climatex/Sentinel/recoverymode_gpio1.jpg

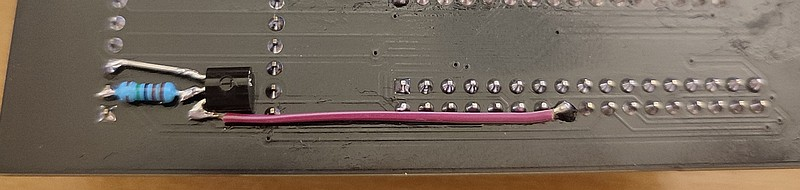
recoverymode_gpio1.jpg
