climatex/Sentinel/README.md

<p align="center">
  Project Sentinel circuit board
</p>

# Project Sentinel, an RPi Pico 2 MFM/RLL disk controller
Check out my [website article](https://boginjr.com/it/hw/sentinel) to learn more!
