climatex/Sentinel/Board/Main/Schematic/Main.png

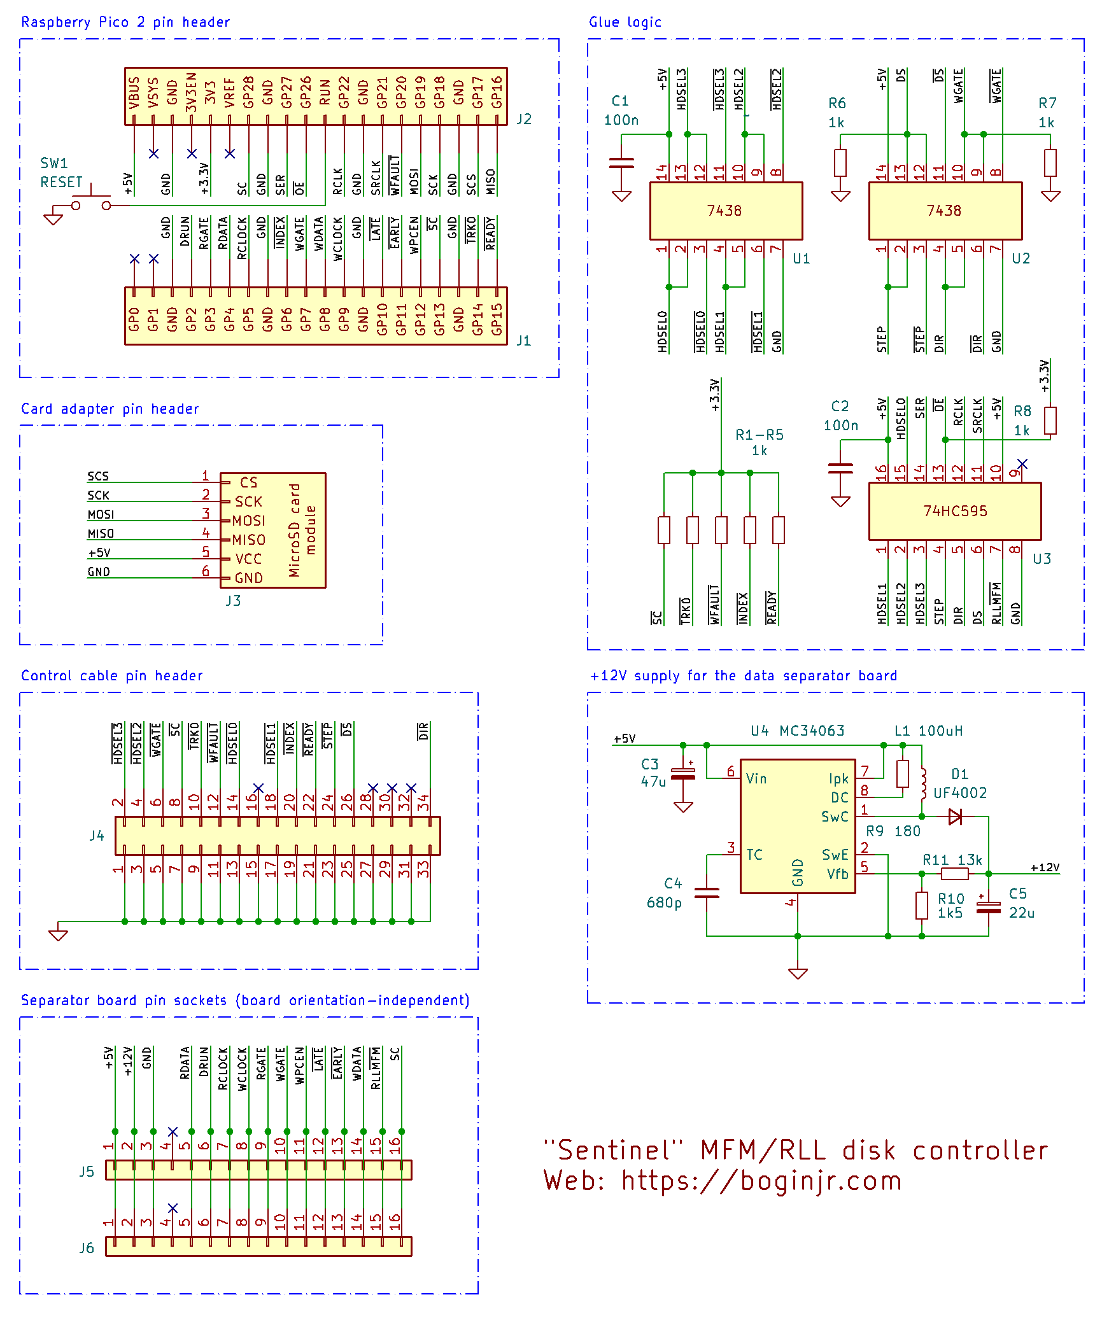
Board/Main/Schematic/Main.png
