climatex/Sentinel/Board/Main/Main.kicad_pcb

## KiCad design Board/Main/Main.kicad_pcb (2026-08-16)

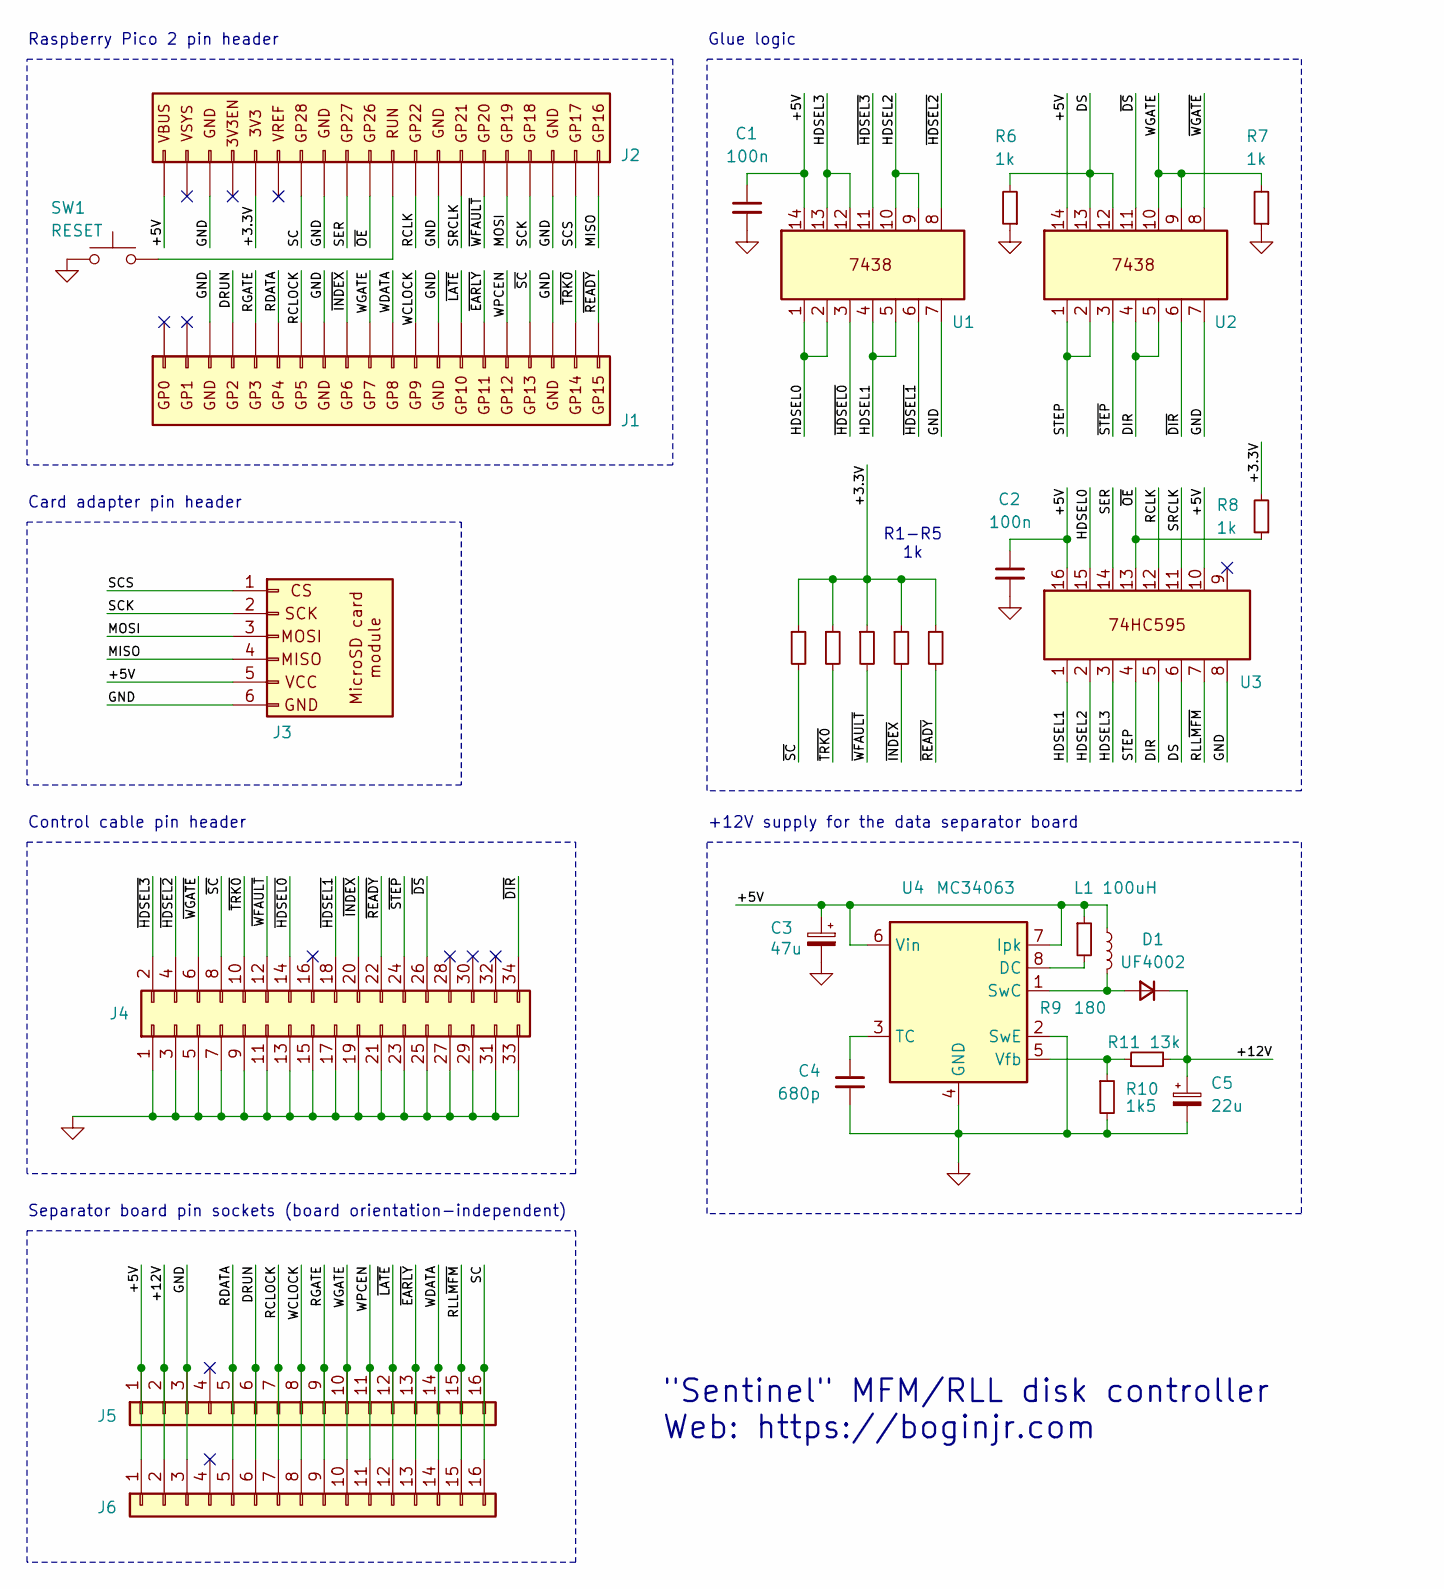
[picture p3: schematic Main.kicad_sch]

Parts:
C1, C2: 100n; C_Disc_D7.5mm_W2.5mm_P5.00mm
C3: 47u; CP_Radial_D6.3mm_P2.50mm
C4: 680p; C_Disc_D7.5mm_W2.5mm_P5.00mm
C5: 22u; CP_Radial_D6.3mm_P2.50mm
D1: UF4002; D_DO-41_SOD81_P10.16mm_Horizontal
J1, J2: Conn_01x20; PinSocket_1x20_P2.54mm_Vertical
J3: Digital; PinHeader_1x06_P2.54mm_Vertical
J4: PinHeader_2x17_P2.54mm_Vertical
J5, J6: Conn_01x16; PinSocket_1x16_P2.54mm_Vertical
L1: 100uH; L_Radial_D8.7mm_P5.00mm_Fastron_07HCP
R1, R2, R3, R4, R5: 10K; R_Axial_DIN0207_L6.3mm_D2.5mm_P10.16mm_Horizontal
R6, R7, R8: 1k; R_Axial_DIN0207_L6.3mm_D2.5mm_P10.16mm_Horizontal
R9: 180; R_Axial_DIN0207_L6.3mm_D2.5mm_P10.16mm_Horizontal
R10: 1k5; R_Axial_DIN0207_L6.3mm_D2.5mm_P10.16mm_Horizontal
R11: 13k; R_Axial_DIN0207_L6.3mm_D2.5mm_P10.16mm_Horizontal
SW1: RESET; SW_PUSH_6mm
U1, U2: DIP-14_W7.62mm_LongPads
U3: DIP-16_W7.62mm_LongPads
U4: MC34063; DIP-8_W7.62mm_LongPads

Connections:
/+3.3V: J2.16, R1.1, R2.1, R3.1, R4.1, R5.1, R8.2
/+5V: C1.1, C2.1, C3.1, J2.20, J3.5, J5.1, J6.1, L1.1, R9.1, U1.14, U2.14, U3.10, U3.16, U4.6 (Vin), U4.7 (Ipk)
/+12V: C5.1, D1.1 (K), J5.2, J6.2, R11.2
/DIR: U2.4, U2.5, U3.5
/DRUN: J1.4, J5.6, J6.6
/DS: R6.2, U2.12, U2.13, U3.6
/HDSEL0: U1.1, U1.2, U3.15
/HDSEL1: U1.4, U1.5, U3.1
/HDSEL2: U1.9, U1.10, U3.2
/HDSEL3: U1.12, U1.13, U3.3
/MISO: J2.1, J3.4
/MOSI: J2.5, J3.3
/RCLK: J2.9, U3.12
/RCLOCK: J1.7, J5.7, J6.7
/RDATA: J1.6, J5.5, J6.5
/RGATE: J1.5, J5.9, J6.9
/RLL~MFM: J5.15, J6.15, U3.7
/SC: J2.14, J5.16, J6.16
/SCK: J2.4, J3.2
/SCS: J2.2, J3.1
/SER: J2.12, U3.14
/SRCLK: J2.7, U3.11
/STEP: U2.1, U2.2, U3.4
/WCLOCK: J1.12, J5.8, J6.8
/WDATA: J1.11, J5.14, J6.14
/WGATE: J1.10, J5.10, J6.10, R7.2, U2.9, U2.10
/WPCEN: J1.16, J5.11, J6.11
/~DIR: J4.34, U2.6
/~DS: J4.26, U2.11
/~EARLY: J1.15, J5.13, J6.13
/~HDSEL0: J4.14, U1.3
/~HDSEL1: J4.18, U1.6
/~HDSEL2: J4.4, U1.8
/~HDSEL3: J4.2, U1.11
/~INDEX: J1.9, J4.20, R4.2
/~LATE: J1.14, J5.12, J6.12
/~OE: J2.11, R8.1, U3.13
/~READY: J1.20, J4.22, R5.2
/~SC: J1.17, J4.8, R1.2
/~STEP: J4.24, U2.3
/~TRK0: J1.19, J4.10, R2.2
/~WFAULT: J2.6, J4.12, R3.2
/~WGATE: J4.6, U2.8
GND: C1.2, C2.2, C3.2, C4.2, C5.2, J1.3, J1.8, J1.13, J1.18, J2.3, J2.8, J2.13, J2.18, J3.6, J4.1, J4.3, J4.5, J4.7, J4.9, J4.11, J4.13, J4.15, J4.17, J4.19, J4.21, J4.23, J4.25, J4.27, J4.29, J4.31, J4.33, J5.3, J6.3, R6.1, R7.1, R10.2, SW1.2, U1.7, U2.7, U3.8, U4.2 (SwE), U4.4 (GND)
unnamed: D1.2 (A), L1.2, U4.1 (SwC)
unnamed: J2.10, SW1.1
unnamed: R9.2, U4.8 (DC)
unnamed: C4.1, U4.3 (TC)
unnamed: R10.1, R11.1, U4.5 (Vfb)

Notes on the sheet:
Card adapter pin header
Raspberry Pico 2 pin header
Control cable pin header
Glue logic
"Sentinel" MFM/RLL disk controller Web: https://boginjr.com
Separator board pin sockets (board orientation-independent)
+12V supply for the data separator board
R1-R5 1k

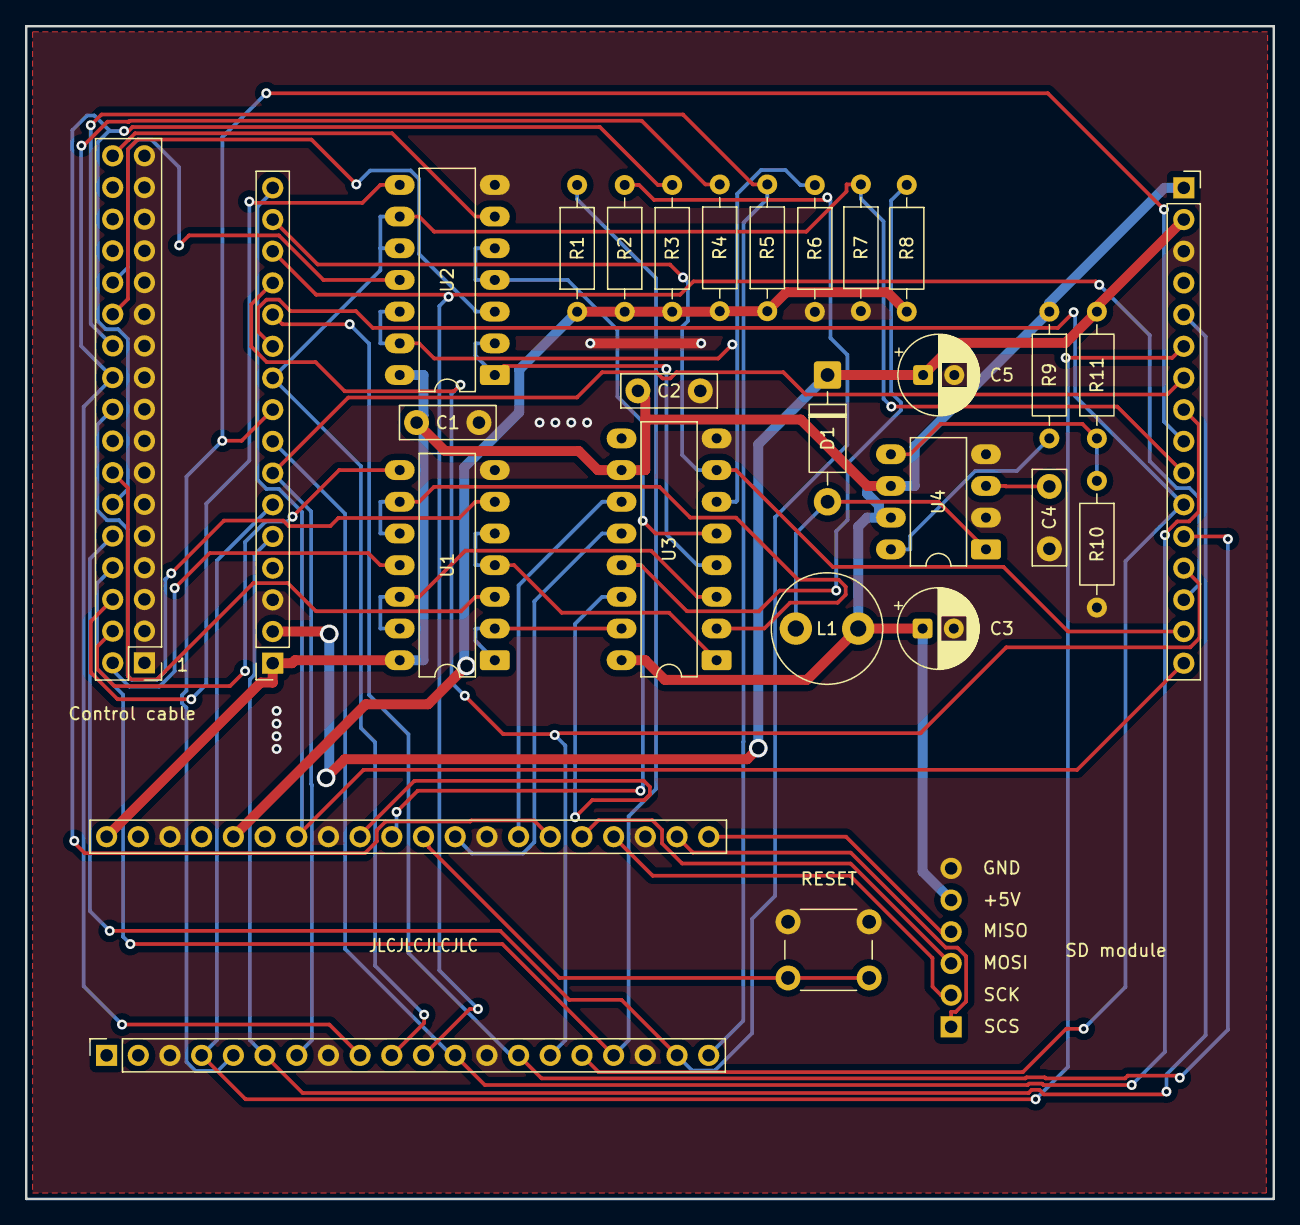
[picture p4: board Main.kicad_pcb from above]

Board: 2 copper layers, 100.0 x 94.0 mm, 29 parts (1 on the bottom side), 49 nets.
