climatex/Sentinel/Source/src/commands.h

// Sentinel (c) 2026 J. Bogin, https://boginjr.com
// Main menu commands

#pragma once
#include "config.h"

// public forward decls

void formatMenu(LLF* format);
void commandAutodetect();
void commandRawdisk();
void commandErase();
void commandSeekTest();
void commandRpmTest();
void commandPark();
