climatex/Sentinel/(commit log)

2026-08-18 Add scripts for track analysis
2026-08-22 findSync(): keep PLL locked longer, increase sysclk to 400MHz, bugfixes
    [config.h, endec.cpp, llf.h, main.cpp, stringtable.h, xebec_adaptec.cpp]
2026-10-05 Bugfixes; more attempts at locating sector ID fields
    [adt.cpp, commands.cpp, config.h, hdc9224.cpp, omti.cpp, seagate.cpp, sm1040.cpp, stringtable.h]
